VasuPadsumbia/micro-ros-ethercat/docs/micro_ros_ethercat_report.docx

# micro-ROS over EtherCAT

A Complete Implementation: ESP32 ↔ SPI ↔ Tang Nano 20K FPGA ↔ EtherCAT ↔ ROS 2 PC

Vasu
April 2026

# 1. Introduction and Motivation

This document covers the complete design, implementation, and debugging of a system that runs micro-ROS on an ESP32 microcontroller and routes its DDS traffic over EtherCAT to a ROS 2 host PC. The idea came from a need to put a small embedded node on a deterministic industrial bus without adding a full Linux board. EtherCAT gives us sub-100 µs cycle times and a daisy-chain topology that suits robotics. micro-ROS lets me reuse the full ROS 2 ecosystem (topics, services, parameters) on a $5 microcontroller.

The main challenge is that micro-ROS was designed to run over serial, UDP, or USB — not EtherCAT. EtherCAT is a master/slave bus; the slave cannot initiate communication. I had to bridge the two worlds by implementing a custom transport layer and building the EtherCAT slave entirely in FPGA logic, since off-the-shelf EtherCAT slave chips (like Beckhoff ET1100) are expensive and hard to source.

Everything in this project is open-source hardware and software: the Tang Nano 20K FPGA (Gowin GW2A-18), SOEM for the PC-side master, and the micro-ROS ESP-IDF component. The entire toolchain — synthesis, place-and-route, firmware build, agent build — runs from a single shell script.

# 2. System Architecture

The data path has four major hops. Figure 1 shows the block diagram.

┌─────────────────────────────────────────────────────────────────────┐
│ ROS 2 Host PC │
│ ┌──────────────────┐ ┌────────────────────────────────┐ │
│ │ micro-ROS Agent │ │ SOEM EtherCAT Master │ │
│ │ (XRCE-DDS ↔ │◄──────►│ ecx_contextt │ │
│ │ DDS bridge) │ │ VoE mailbox R/W │ │
│ └──────────────────┘ └────────────┬───────────────────┘ │
│ │ Ethernet (NIC) │
└────────────────────────────────────────────┼───────────────────────┘
│ 100BASE-TX
▼
┌─────────────────────────────────────────────────────────────────────┐
│ Tang Nano 20K (GW2A-18C) │
│ │
│ ┌──────────┐ ┌──────────┐ ┌────────────┐ ┌──────────────────┐ │
│ │ mii_mac │ │ ethercat │ │ esc_ │ │ mailbox │ │
│ │ Port 0 │─►│ _slave │─►│ registers │─►│ SM0(out) 256B │ │
│ │ (MII RX/ │ │ datagram │ │ 4 KiB │ │ SM1(in) 256B │ │
│ │ TX + FCS│ │ parser │ │ BRAM │ │ │ │
│ └──────────┘ └──────────┘ └────────────┘ └────────┬─────────┘ │
│ │ spi_slave │
│ ┌──────────────────────────────────────────────────┐ │ │
│ │ mdio_ctrl → AT24C256 EEPROM (i2c_master) │ │ SPI 8MHz │
│ └──────────────────────────────────────────────────┘ │ │
└─────────────────────────────────────────────────────────────────────┘
│
┌────────────────────────────────────────────┘
│ SPI (Mode 0, 8 MHz, CPOL=0, CPHA=0)
│ SCK=GPIO14, MOSI=GPIO13, MISO=GPIO12, CS=GPIO15
│ INT_N=GPIO4 (active-low interrupt from FPGA)
▼
┌───────────────────────────────────────┐
│ ESP32 DevKit V4 │
│ ┌────────────────────────────────┐ │
│ │ micro-ROS (FreeRTOS task) │ │
│ │ rcl / rclc / rmw_microxrcedds│ │
│ │ custom SPI transport │ │
│ │ rmw_uros_set_custom_transport │ │
│ └────────────────────────────────┘ │
└───────────────────────────────────────┘

Figure 1 — Complete system block diagram.

## 2.1 Signal Flow Summary

When the ESP32 publishes a ROS 2 message, the micro-XRCE-DDS serialises it into a UDP-like datagram and hands it to the custom SPI transport. The transport frames it with a 3-byte header (CMD, LEN_H, LEN_L) and a CRC-8 trailer and clocks it into the FPGA over SPI. The FPGA's spi_slave module writes each byte into the SM0 (Mailbox Out) buffer. When the buffer is full, it asserts INT_N low to signal the PC. The PC-side SOEM thread reads the mailbox over EtherCAT using a VoE (Vendor-specific over EtherCAT) read command and passes the raw bytes to the micro-ROS agent. The agent deserialises the XRCE-DDS stream and publishes it into the ROS 2 DDS middleware. The return path is symmetric.

# 3. EtherCAT Protocol Deep Dive

## 3.1 What EtherCAT Is

EtherCAT (Ethernet for Control Automation Technology) is an industrial Ethernet fieldbus standardised as IEC 61158 Type 12. Unlike standard Ethernet where each node receives a packet and sends a reply, EtherCAT uses a "processing-on-the-fly" model. The master sends a frame; each slave reads its portion of the frame and writes back its data into the same frame as it passes through. The last slave in the ring sends the completed frame back to the master. A single 1500-byte Ethernet frame can carry data for all slaves in one cycle.

Key properties that made EtherCAT attractive for this project:

- Deterministic cycle time: typical 31.25 µs to 1 ms, jitter < 1 µs with distributed clocks.
- Standard 100BASE-TX physical layer — uses off-the-shelf DP83848 PHY chips.
- Master runs on a standard PC NIC with no special hardware — only SOEM (open-source library).
- Mailbox protocol for non-cyclic (event-driven) communication — perfect for micro-ROS DDS.
- Daisy-chain topology, no switch needed.

## 3.2 EtherCAT Frame Structure

An EtherCAT frame is a standard Ethernet frame with Ethertype 0x88A4. The payload is one or more EtherCAT datagrams back-to-back:

Ethernet frame:
┌──────────┬──────────┬────────┬──────────────────────────────┬─────┐
│ Dst MAC │ Src MAC │ 0x88A4│ EtherCAT payload (datagrams)│ FCS │
│ 6 bytes │ 6 bytes │ 2 bytes│ up to 1498 bytes │4 B │
└──────────┴──────────┴────────┴──────────────────────────────┴─────┘

EtherCAT datagram (one of N in the payload):
┌────┬────┬──────────┬───────┬────┬────────────────┬─────┬─────┐
│CMD │IDX │ Address │LENGTH │IRQ │ Data │ WKC │ M │
│1 B │1 B │ 4 bytes │ 2 B │2 B │ 0..1486 bytes │2 B │ bit │
└────┴────┴──────────┴───────┴────┴────────────────┴─────┴─────┘
CMD : command — APRD, APWR, FPRD, FPWR, LRD, LWR, BRD, BWR, ARMW...
IDX : index (echo-back ID, incremented by master each cycle)
Address: 32-bit address (auto-increment or fixed-station + offset)
LENGTH : bits[10:0]=data length, bit[14]=circulating, bit[15]=M(ore)
WKC : Working Counter, each matching slave increments by 1, 2, or 3
M bit : set if another datagram follows in this frame

## 3.3 Datagram Commands

Command | Mnemonic | Address Type | Use in This Project
APRD | Auto-Increment Physical Read | Position-based | Master reads data FROM slave
APWR | Auto-Increment Physical Write | Position-based | Master writes data TO slave
FPRD | Fixed-address Physical Read | Station address | After address assignment
FPWR | Fixed-address Physical Write | Station address | Register writes (mailbox)
BRD | Broadcast Read | All slaves | AL status poll
LRW | Logical Read/Write | Logical address | Process data (PDO mapping)
FRMW | Fixed Addr Read Multiple Write | Station address | Distributed clock reference

## 3.4 ESC Register Map (IEC 61158-4-12)

Every EtherCAT slave has a register space (the ESC — EtherCAT Slave Controller). Our FPGA implements this register file in esc_registers.v. The key registers are:

Address | Register | Width | Description
0x0000 | Type | 8 bit | ESC type (0x11 = IP Core with 2 ports)
0x0001 | Revision | 8 bit | 0x01
0x0004–0x0007 | Build | 32 bit | ESC build number
0x0008 | FMMU supported | 8 bit | 8 FMMUs
0x0009 | SM supported | 8 bit | 8 SyncManagers
0x000A | RAM size | 8 bit | 0x10 = 4 KiB
0x0010–0x0011 | Station address | 16 bit | Assigned by master (APWR broadcast)
0x0100 | DL Control | 8 bit | Port enable, loop control
0x0110 | DL Status | 8 bit | Link status
0x0120 | AL Control | 8 bit | Master writes desired state here
0x0130 | AL Status | 8 bit | Slave reports current state
0x0134 | AL Status Code | 16 bit | Error reason
0x0500–0x0507 | EEPROM ctrl/addr/data | — | SII EEPROM access
0x0800–0x083F | SM0–SM7 config | 8×8 bytes | SyncManager 0–7 configuration
0x1000–0x11FF | Dual-port RAM | 512 B | SM0/SM1 mailbox data

## 3.5 AL State Machine

Every EtherCAT slave must implement the Application Layer state machine. The master drives it by writing to AL Control (0x0120); the slave responds by updating AL Status (0x0130). Our implementation in ethercat_slave.v handles the transitions:

INIT (0x01) ──────────────────────────────────────────────────────────────────────►
│ Master configures SyncManagers and FMMUs │
▼ │
PRE-OP (0x02) ──────────────────────────────────────────────────────────────────► │
│ Mailbox communication enabled (SM0/SM1 active) │
▼ │
SAFE-OP (0x04) │
│ Process data inputs run, outputs frozen at 0 │
▼ │
OP (0x08) ◄──── normal operation, all I/O active ──────────────────────────

## 3.6 SyncManager Configuration

SyncManagers are the hardware mechanism that controls mailbox and process data access. Each SM has 8 bytes of configuration at offset 0x0800 + n×8:

Byte offset | Field | Our SM0 (Mailbox Out) | Our SM1 (Mailbox In)
0–1 | Start address | 0x1000 | 0x1100
2–3 | Length | 0x0100 (256 B) | 0x0100 (256 B)
4 | Control | 0x26 (write, Mailbox) | 0x22 (read, Mailbox)
5 | Status | HW managed | HW managed
6 | Activate | 0x01 (enabled) | 0x01 (enabled)
7 | PDI Control | HW managed | HW managed

SM0 is the "Mailbox Out" channel: the master writes data here (FPRD/FPWR to 0x1000–0x10FF). SM1 is "Mailbox In": the master reads from here (FPRD to 0x1100–0x11FF). The working counter mechanism ensures the master knows whether the slave has consumed/produced data.

## 3.7 VoE — Vendor-specific over EtherCAT

The mailbox protocol at the EtherCAT level supports several sub-protocols: CoE (CANopen), SoE (SERCOS), EoE (Ethernet), and VoE (Vendor-specific). I chose VoE because it has no predefined schema — I can put raw bytes in the mailbox and define my own framing on top. A VoE mailbox header is 6 bytes:

EtherCAT mailbox header (6 bytes):
┌──────────────────┬──────────┬────────┬──────┬────────────────────┐
│ Length (2B LE) │ Addr(2B) │Cnt/Prio│ Type │ VoE body │
│ = body length │ 0x0000 │ 0x00 │ 0x0F │ raw XRCE-DDS data │
└──────────────────┴──────────┴────────┴──────┴────────────────────┘
Type 0x0F = VoE

In practice, the SOEM bridge on the PC side reads the raw mailbox buffer and strips the 6-byte EtherCAT header before passing the payload to the micro-ROS agent. This gives us a transparent byte pipe between the ESP32 and the PC, which is exactly what micro-XRCE-DDS needs.

## 3.8 EtherCAT Performance Characteristics

Parameter | Value | Notes
Physical layer | 100BASE-TX | Full-duplex, 100 Mbit/s raw
Effective throughput per slave | ~90 Mbit/s | After preamble/IFG/FCS overhead
Cycle time (typical) | 31.25 µs – 1 ms | Configurable by master
Cycle time jitter | < 1 µs | With distributed clocks enabled
Max datagrams per frame | ~15 | At 1500 B MTU, 10 B header each
Max mailbox size | 1486 B | Limited by Ethernet MTU
Our mailbox size | 256 B | Matches micro-ROS MTU
Max slaves per segment | 65535 | Theoretical; practical < 100
Propagation delay per slave | ~100 ns | FPGA ESC processing latency
SOEM min cycle achievable | ~125 µs | On a Linux RT kernel

# 4. Hardware Components

## 4.1 Tang Nano 20K — GW2A-18C FPGA

The Tang Nano 20K is a low-cost ($18) FPGA development board from Sipeed. The core chip is the Gowin GW2A-18C:

Resource | Count | Used (estimated) | Utilisation
LUT4 (logic cells) | 20,736 | ~2,400 | ~11.6 %
Flip-flops (DFF) | 15,552 | ~1,500 ctrl + 4K mem regs | ~35 %
Block RAM 18Kbit | 55 | 4 (pd_ram, sm0, sm1, eeprom) | 7.3 %
DSP blocks | 48 | 0 | 0 %
Global clocks | 8 | 4 (sys, tx_clk, rx_clk0, rx_clk1) | 50 %
User IO | 83 | ~50 | ~60 %
PLL | 2 | 0 (using onboard 27 MHz directly) | 0 %

The GW2A-18C has 55 BRAM blocks at 18 Kbit each — that is about 123 KB of block RAM total. This is more than sufficient for our EtherCAT buffers. The device is supported by the open-source toolchain apio (yosys + nextpnr-himbaechel + gowin-pack) which we install inside a Python virtual environment — no proprietary IDE required.

## 4.2 ESP32 DevKit V4

The ESP32 is a dual-core 240 MHz Xtensa LX6 microcontroller with 520 KB SRAM and 4 MB flash. We use one core (core 1) for the micro-ROS FreeRTOS task and the other for the system idle task. The SPI peripheral (SPI2 / HSPI) is configured in master mode at 8 MHz. The relevant pins:

GPIO | SPI Signal | Connected to FPGA pin | Direction
GPIO14 | SCLK | spi_sck | ESP32 → FPGA
GPIO13 | MOSI | spi_mosi | ESP32 → FPGA
GPIO12 | MISO | spi_miso | FPGA → ESP32
GPIO15 | CS (active-low) | spi_cs_n | ESP32 → FPGA
GPIO4 | INT_N (active-low interrupt) | spi_int_n | FPGA → ESP32

## 4.3 DP83848 Ethernet PHY

Two DP83848 PHY chips are used (one per EtherCAT port). The PHY handles the analogue 100BASE-TX signalling and presents a 4-bit MII interface to the FPGA running at 25 MHz. The FPGA's mii_mac module connects to this interface. Both PHYs are managed via MDIO (Management Data Input/Output) — a serial protocol at ~2.5 MHz that we implement in mdio_ctrl.v. At startup, mdio_ctrl writes the PHY registers to force 100 Mbit/s full-duplex and enable auto-negotiation.

MII interface pinout per PHY:

TX side (FPGA → PHY, synchronous to TX_CLK from PHY):
TXD[3:0] — 4-bit transmit nibbles
TX_EN — transmit enable
TX_ER — transmit error (we tie low)
TX_CLK — 25 MHz clock INPUT from PHY (FPGA uses this)

RX side (PHY → FPGA, synchronous to RX_CLK from PHY):
RXD[3:0] — 4-bit receive nibbles
RX_DV — receive data valid
RX_ER — receive error
RX_CLK — 25 MHz clock INPUT from PHY

## 4.4 AT24C256 EEPROM

EtherCAT requires each slave to have a small EEPROM (called the SII — Slave Information Interface) that stores vendor ID, product code, mailbox configuration, and CoE object dictionary metadata. The master reads this over MDIO-like SII protocol at startup. We implement the SII in a 256-word (512-byte) cache in BRAM, populated from the AT24C256 (32 KB I2C EEPROM) at boot. The i2c_master.v module reads the EEPROM; the ESC register block services the master's EEPROM read requests.

# 5. FPGA RTL Architecture

## 5.1 Module Hierarchy

top.v
├── mdio_ctrl.v — PHY MDIO initialisation
├── mii_mac.v (×2) — MII MAC with TX preamble/FCS and RX FCS check
├── ethercat_slave.v — EtherCAT datagram processing state machine
├── esc_registers.v — ESC register file + process data RAM
├── mailbox.v — SM0/SM1 buffers + INT_N generation
├── spi_slave.v — SPI slave interface to ESP32
├── i2c_master.v — I2C master for AT24C256 EEPROM
└── crc32.v / (inline) — CRC-32 for Ethernet FCS (nibble-serial)

## 5.2 Clock Domains

Domain | Source | Frequency | Used by
sys_clk (clk_27) | Tang Nano 20K onboard crystal | 27 MHz | All control logic, SPI slave, I2C, register file
tx_clk0 | PHY0 TX_CLK output | 25 MHz | mii_mac port 0 TX state machine
rx_clk0 | PHY0 RX_CLK output | 25 MHz | mii_mac port 0 RX state machine
tx_clk1 | PHY1 TX_CLK output | 25 MHz | mii_mac port 1 TX (currently tied off)
rx_clk1 | PHY1 RX_CLK output | 25 MHz | mii_mac port 1 RX (currently tied off)

All clock domain crossings between the 25 MHz MII domains and the 27 MHz system clock are handled by 2FF synchronisers and Gray-coded pointer asynchronous FIFOs inside mii_mac.v. No PLL is used — the PHY generates a clean 25 MHz from its internal crystal oscillator.

## 5.3 mii_mac.v — MII MAC Layer

The MII MAC is the lowest layer. It translates between the 4-bit MII nibble stream (running at 25 MHz, one nibble per clock) and the byte-stream interface used by the EtherCAT slave core (running at 27 MHz). It handles:

- TX: preamble (7 × 0x55) + SFD (0xD5) generation, CRC-32 FCS append, inter-frame gap (96-bit = 24 nibble clocks).
- RX: preamble stripping, SFD detection, byte assembly, CRC-32 FCS check (residue = 0xC704DD7B).
- Clock domain crossing: 64-entry async FIFO per direction with Gray-coded pointers.

The CRC-32 is computed nibble-by-nibble using the reflected polynomial 0xEDB88320:

function [31:0] crc32_nibble;
input [31:0] crc;
input [3:0] nib;
for (k = 0; k < 4; k = k + 1) begin
if (crc[0] ^ nib[k])
crc = {1'b0, crc[31:1]} ^ 32'hEDB88320;
else
crc = {1'b0, crc[31:1]};
end
endfunction

The async FIFO uses a 7-bit Gray-coded write pointer and a 7-bit Gray-coded read pointer (2-stage synchronised into the opposite domain). Binary recovery uses a chain of XOR gates implemented as an upward-counting generate loop (downward loops caused yosys to hang — a bug we hit and fixed). The FIFO depth is 2^6 = 64 entries — enough for several Ethernet frame bytes to buffer while the 27 MHz domain catches up.

## 5.4 ethercat_slave.v — Datagram Processing

This module receives frames from the mii_mac and processes them byte by byte. It maintains a 512-byte frame buffer (fbuf) in registers. Originally this was 2 KB (2048 bytes), which would have created 16,384 flip-flops — enough to stall yosys for over an hour. Reducing to 512 bytes is correct because our largest EtherCAT mailbox frame is 14 (Eth) + 2 (EtherCAT) + 10 (datagram) + 256 (payload) = 282 bytes.

The receive state machine has three states:

RX_COLLECT — collect bytes into fbuf until rx_last
RX_PROCESS — parse datagrams: check Ethertype 0x88A4, iterate datagrams,
check address match, read/write ESC registers, increment WKC
RX_TRANSMIT — replay modified fbuf through the TX MAC

For each datagram, the module checks whether the datagram's address matches this slave (either auto-increment position check or fixed station address comparison). If it matches, it reads/writes the ESC register space via ec_addr/ec_wdata/ec_rdata. Working counter (WKC) is incremented according to the command type: +1 for read, +1 for write, +3 for read-write (ARMW).

Supported datagram commands (implemented):

- APRD (0x01) — Auto-increment physical read: reads ESC registers by position.
- APWR (0x02) — Auto-increment physical write: writes ESC registers by position.
- FPRD (0x04) — Fixed-station physical read: uses station address register.
- FPWR (0x05) — Fixed-station physical write.
- BRD (0x07) — Broadcast read.
- BWR (0x08) — Broadcast write.

## 5.5 esc_registers.v — Register File

This module implements the full ESC register map as a 16-bit addressed combinatorial decode (casez on ec_addr). Writable registers are backed by register arrays; read-only fields return constants. The key storage elements:

Symbol | Type | Size | Purpose
station_addr_r | reg [7:0][0:1] | 2 bytes | Assigned station address (0x0010)
dl_ctrl_r | reg [7:0][0:1] | 2 bytes | DL control register (0x0100)
al_ctrl_r | reg [7:0][0:1] | 2 bytes | AL control — desired state (0x0120)
sm_r | reg [63:0][0:7] | 64 bytes | 8 SyncManagers × 8 bytes config (0x0800)
eeprom_cache | BRAM 256 B | 256 bytes | SII EEPROM shadow (first 128 words)
pd_ram | reg [7:0][0:511] | 512 bytes | Process data RAM (0x1000–0x11FF)

A key design lesson: the pd_ram originally used a 12-bit index (4096 entries = 32,768 flip-flops) which crashed yosys. Reducing to 9-bit (512 entries matching SM0+SM1 = 0x1000–0x11FF) brought the register count down to manageable levels. The sm_r register is packed as a flat 512-bit vector for Verilog-2001 compatibility (yosys does not support SystemVerilog 2D packed arrays in port declarations).

## 5.6 mailbox.v — SM0/SM1 Buffers

The mailbox module manages two 256-byte buffers: SM0 (Mailbox Out — master writes, SPI reads) and SM1 (Mailbox In — SPI writes, master reads). It also generates the INT_N interrupt signal to the ESP32 (active-low, asserted when SM0 has data for the ESP32 to read).

SM0 write (EtherCAT master → SM0 → ESP32 via SPI):
1. Master sends FPWR datagram to address 0x1000–0x10FF
2. ethercat_slave asserts ec_wr for each byte
3. mailbox stores byte at sm0_buf[ec_addr - MBX_OUT_BASE]
4. On sm0_written pulse, mailbox sets mbox_out_ready=1, asserts INT_N
5. spi_slave detects INT_N and sends data to ESP32 on next CMD=0x02 read

SM1 write (ESP32 via SPI → SM1 → EtherCAT master):
1. ESP32 sends CMD=0x01 write to spi_slave
2. spi_slave asserts mbox_wr_valid for each payload byte
3. mailbox stores byte at sm1_buf[sm1_wr_ptr++]
4. When full, sets mbox_in_ready=1
5. Master polls SM1 (FPRD 0x1100), sees data, reads it

## 5.7 spi_slave.v — SPI Interface

The SPI slave runs Mode 0 (CPOL=0, CPHA=0), MSB first, at up to 8 MHz. The SPI clock from the ESP32 is asynchronous to the 27 MHz sys_clk, so the module uses a 3-stage synchroniser on SCK, CS, and MOSI before edge detection:

sck_rise = (sck_sync[2:1] == 2'b01) // rising edge
sck_fall = (sck_sync[2:1] == 2'b10) // falling edge
cs_active = !cs_sync[1]

The SPI protocol uses a 3-byte header + payload + CRC-8:

Frame format (both TX and RX):
Byte 0 : Command
0x01 = Write to FPGA mailbox (ESP32 → FPGA)
0x02 = Read from FPGA mailbox (FPGA → ESP32)
0x03 = Status query
Byte 1–2 : Payload length (big-endian, 16-bit)
Byte 3…N : Payload
Byte N+1 : CRC-8 (poly 0x07, init 0x00) over bytes 0…N

Status response (CMD=0x03), 3 bytes:
Byte 0 : Flags — bit0=rx_data_available, bit1=tx_ready
Byte 1–2: Number of bytes available in SM0

The state machine (F_CMD → F_LEN_H → F_LEN_L → F_DATA → F_CRC) runs in a single clocked always block. MISO is pre-loaded with the next byte on each falling edge of SCK so data is stable before the next rising edge capture.

# 6. Complete Wiring Diagram

┌──────────────────────────────────────────────────────────────────────────────┐
│ WIRING DIAGRAM — micro-ROS over EtherCAT │
└──────────────────────────────────────────────────────────────────────────────┘

PC (Ubuntu / ROS 2)
NIC eth0 ──────── RJ45 patch cable ──────────────────────────────────────┐
│
100BASE-TX (Cat5e/6) │
│
Tang Nano 20K FPGA Board │
┌──────────────────────────────────────────────────────────────────────┐ │
│ │ │
│ DP83848 PHY0 │ │
│ RJ45 ──── MDI pairs ───► PHY0 ────────────────────────────────────┼──┘
│ │ │
│ TX_CLK (25 MHz) ─────────┼───► FPGA pin p0_tx_clk │
│ RX_CLK (25 MHz) ─────────┼───► FPGA pin p0_rx_clk │
│ TXD[3:0] ◄────────┼──── FPGA pin p0_txd[3:0] │
│ TX_EN ◄────────┼──── FPGA pin p0_tx_en │
│ RXD[3:0] ─────────┼───► FPGA pin p0_rxd[3:0] │
│ RX_DV ─────────┼───► FPGA pin p0_rx_dv │
│ MDC ◄────────┼──── FPGA pin p0_mdc │
│ MDIO ◄───────►┼──── FPGA pin p0_mdio (open-drain) │
│ RST_N ◄────────┼──── FPGA pin p0_rst_n │
│ │ │
│ AT24C256 EEPROM │ │
│ SCL ◄───────────────────────── FPGA i2c_scl (open-drain) │
│ SDA ◄──────────────────────── FPGA i2c_sda (open-drain) │
│ VCC = 3.3V, GND, A0=A1=A2=0 (addr 0x50) │
│ │
│ SPI slave port │
│ spi_sck ─────────────────────────────────────────────────────┐ │
│ spi_mosi ──────────────────────────────────────────────────┐ │ │
│ spi_miso ───────────────────────────────────────────────┐ │ │ │
│ spi_cs_n ────────────────────────────────────────────┐ │ │ │ │
│ spi_int_n────────────────────────────────────────────┼──┼──┼──┼───┼─┐
│ │ │ │ │ │ │
└─────────────────────────────────────────────────────────┼──┼──┼──┼───┘ │
│ │ │ │ │
ESP32 DevKit V4 │ │ │ │ │
┌─────────────────────────────────────────────────────────┴──┴──┴──┴──┐ │
│ GPIO15 (CS) ────────────────────────────────────────────────────┘ │
│ GPIO14 (SCLK) │
│ GPIO13 (MOSI) │
│ GPIO12 (MISO) │
│ GPIO4 (INT_N) ◄──────────────────────────────────────────────────────┘
│ │
│ SPI2 (HSPI) peripheral — Mode 0, 8 MHz, MSB first │
│ FreeRTOS + micro-ROS task │
└─────────────────────────────────────────────────────────────────────────┘

Power:
Tang Nano 20K : USB-C 5V (onboard regulator → 3.3V for FPGA and PHYs)
ESP32 DevKit : USB Micro-B 5V (onboard regulator → 3.3V)
Logic levels : 3.3V on all signal lines (compatible)

# 7. ESP32 Firmware — micro-ROS over SPI

## 7.1 micro-ROS Architecture

micro-ROS runs on top of FreeRTOS using the ESP-IDF component micro_ros_espidf_component. The stack is:

ROS 2 application layer: rcl (ROS Client Library)
rclc (C convenience layer: executor, timers)
Middleware: rmw_microxrcedds (RMW implementation)
Transport: XRCE-DDS (micro-XRCE-DDS-Client)
Custom transport: spi_transport.c (our implementation)
Hardware: ESP32 SPI2 (HSPI)

The custom transport is registered at startup with rmw_uros_set_custom_transport(), providing four callbacks: open, close, write, read. This function is only available when the micro-ROS library is compiled with RMW_UXRCE_TRANSPORT=custom in app-colcon.meta — a lesson we learned after a linker error showed the symbol missing from libmicroros.a (which had been built with RMW_UXRCE_TRANSPORT=udp).

## 7.2 SPI Transport Implementation

The write callback:

1. Poll FPGA status via CMD=0x03 until TX_READY bit is set (up to 100 ms).
2. Build SPI frame: [0x01][LEN_H][LEN_L][payload][CRC8].
3. Execute full-duplex SPI transaction via spi_device_polling_transmit().

The read callback:

4. Poll until RX_DATA_AVAILABLE bit is set or timeout expires.
5. Send CMD=0x02 with length from status response.
6. Extract payload from SPI RX buffer, verify CRC-8.

CRC-8 uses polynomial 0x07, init 0x00 — computed over all bytes from CMD through the last payload byte. This detects single-bit errors on the SPI lines.

## 7.3 Build System — ESP-IDF

The firmware build uses ESP-IDF v5.3, installed to tools/esp-idf/ (not the default ~/.espressif). The IDF_TOOLS_PATH environment variable redirects the toolchain downloads to tools/espressif/. A critical issue was that running idf.py inside an active Python venv caused "cannot import yaml" — the IDF uses its own Python env (idf5.3_py3.14_env) and the project venv was shadowing it. The fix in run.sh strips .venv/bin from PATH before sourcing export.sh.

# 8. PC Agent — SOEM + micro-ROS

## 8.1 SOEM — Simple Open EtherCAT Master

SOEM is an open-source EtherCAT master library written in C. It runs on a raw socket (Linux) and sends/receives EtherCAT frames directly, bypassing the kernel's network stack. The modern SOEM API uses a context object (ecx_contextt) that embeds all state — no external arrays need to be wired up:

ecx_contextt ctx_; // single context object, fully self-contained
uint8_t iobuf_[4096]; // I/O map buffer

memset(&ctx_, 0, sizeof(ctx_));
ecx_config_init(&ctx_); // 1 argument (not 2 — old API had FALSE)
ecx_config_map_group(&ctx_, iobuf_, 0); // not ecx_config_map
ecx_configdc(&ctx_);

A common pitfall: the ecx_portt type (needed by ecx_contextt) is defined in the Linux oshw header (nicdrv.h), which must be included BEFORE ec_main.h. The build would fail with "ecx_portt undeclared" without this ordering.

## 8.2 VoE Mailbox Bridge

The soem_bridge.cpp module runs two threads: a TX thread that reads from the micro-ROS agent output queue and writes to the slave mailbox via FPWR datagrams, and an RX thread that polls the slave mailbox via FPRD datagrams and feeds incoming bytes to the agent input queue. The poll interval is 1 ms (yielding effective micro-ROS latency of 1–2 ms end-to-end).

The mailbox write sequence in SOEM:

// Write to SM0 (Mailbox Out at 0x1000, slave 1)
ecx_mbxsend(&ctx_, 1 /*slave*/, &mbx_out, EC_TIMEOUTTXM);

// Read from SM1 (Mailbox In at 0x1100)
ecx_mbxreceive(&ctx_, 1, &mbx_in, EC_TIMEOUTTXM);

# 9. Build System and Toolchain

## 9.1 Directory Structure

micro-ros-ethercat/
├── run.sh — main orchestrator script
├── config.in — build configuration variables
├── setup.sh — one-time environment setup
├── .venv/ — Python virtual environment (apio, etc.)
├── tools/
│ ├── esp-idf/ — ESP-IDF v5.3 source
│ ├── espressif/ — ESP-IDF toolchain (xtensa-esp-elf, etc.)
│ └── apio/ — apio packages (oss-cad-suite, gowin)
├── ethercat-slave/
│ ├── rtl/ — Verilog RTL source files
│ ├── sim/ — Testbenches (guarded with `ifndef SYNTHESIZE)
│ ├── eeprom/ — EEPROM binary generator
│ └── apio.ini — apio project: board=sipeed-tang-nano-20k
├── firmware/
│ ├── main/ — main.c, spi_transport.c/h
│ ├── components/ — micro_ros_espidf_component
│ ├── app-colcon.meta — override: RMW_UXRCE_TRANSPORT=custom
│ └── sdkconfig.defaults — IDF target, flash size, SPI config
├── agent/
│ ├── src/ — ethercat_transport.cpp, soem_bridge.cpp
│ ├── include/ — ethercat_transport.h
│ ├── test/ — GTest unit tests with mock SOEM
│ └── soem/ — SOEM git submodule
└── logs/ — per-command build logs

## 9.2 run.sh Command Reference

Command | What it does | Log file
./run.sh --build agent | CMake + make of PC agent (libSOEM + GTest) | logs/build_agent.log
./run.sh --build firmware | idf.py build of ESP32 firmware | logs/build_firmware.log
./run.sh --build slave | apio build: yosys + nextpnr + gowin-pack | logs/build_slave.log
./run.sh --build all | All three above in sequence | logs/build_all.log
./run.sh --test agent | cmake -DBUILD_TESTS=ON + ctest | logs/test_agent.log
./run.sh --load-ecat | apio upload: flash FPGA bitstream via USB | logs/load-ecat.log
./run.sh --load-mcu | idf.py flash over UART | logs/load-mcu.log
./run.sh --run agent | sudo ./agent --iface eth0 --slave 1 | logs/run.log
./run.sh --clean all | Remove all generated files (tools/, .venv/, builds) | —

## 9.3 apio — FPGA Toolchain

apio is a pip-installable wrapper around oss-cad-suite that manages yosys (synthesis), nextpnr (place-and-route), and gowin-pack (bitstream generation). Key configuration in ethercat-slave/apio.ini:

[env:default]
board = sipeed-tang-nano-20k
top-module = top

apio passes -DSYNTHESIZE to yosys, so testbench files are wrapped with `ifndef SYNTHESIZE / `endif to prevent simulation code from being synthesised. The APIO_HOME environment variable (not APIO_HOME_DIR) controls where apio installs its packages — we set it to tools/apio/ to keep everything in-workspace.

# 10. Issues Faced and How We Solved Them

This section documents every significant problem encountered during development, in roughly chronological order. I am including it because these are the kinds of things that take hours to debug and are rarely written down.

## 10.1 SOEM: ecx_portt undeclared

Problem:

Including ec_main.h before nicdrv.h caused ecx_portt to be undefined.

Solution:

nicdrv.h (from oshw/linux/) must be included BEFORE ec_main.h. The ecx_portt struct is defined in the OS-specific hardware layer, not the core SOEM headers.

## 10.2 SOEM: ecx_config_init takes 1 argument, not 2

Problem:

Old SOEM docs/examples showed ecx_config_init(&ctx, FALSE). Modern SOEM embeds all arrays inside ecx_contextt — no external arrays, no second argument.

Solution:

Changed to ecx_config_init(&ctx_). Also ecx_config_map() no longer exists; use ecx_config_map_group(&ctx_, iobuf_, 0).

## 10.3 Mock SOEM for GTest: C-linkage overload error

Problem:

Declaring mock functions in a C++ header with extern "C" and then having C++ overloads caused a compilation error.

Solution:

Split declarations into a separate mock_soem.cpp with the extern "C" block. The header includes the SOEM headers in the correct order.

## 10.4 ESP-IDF venv conflict

Problem:

Running ./run.sh inside an active Python venv caused install.sh to fail because it tried to use the venv's pip instead of the system pip.

Solution:

The install.sh subshell unsets VIRTUAL_ENV and VIRTUAL_ENV_PROMPT, and strips .venv/bin from PATH before running.

## 10.5 idf.py: "Cannot import yaml"

Problem:

idf.py was found in PATH but the .venv Python (which lacks yaml) was used instead of the ESP-IDF Python env.

Solution:

require_idf() in run.sh strips .venv/bin from PATH before sourcing export.sh, allowing the ESP-IDF Python env to take precedence.

## 10.6 micro-ROS: rmw_uros_set_custom_transport undefined at link

Problem:

The function compiled fine but was missing from libmicroros.a at link time.

Solution:

libmicroros.a was built with RMW_UXRCE_TRANSPORT=udp. Created app-colcon.meta with RMW_UXRCE_TRANSPORT=custom. Deleted micro_ros_src/ and libmicroros.a to force a full rebuild of the micro-ROS library.

## 10.7 Verilog: SystemVerilog array ports rejected by yosys

Problem:

output wire [63:0] sm_cfg [0:7] is SystemVerilog unpacked array syntax, not Verilog-2001. yosys errored with "syntax error, unexpected [" at port list.

Solution:

Flattened to output wire [511:0] sm_cfg (8 × 64 = 512 bits packed vector). Similarly, reg [7:0] sm_r [0:7][0:7] was flattened to reg [63:0] sm_r [0:7].

## 10.8 Verilog: output reg with assign statement

Problem:

al_control, station_addr, dl_ctrl were declared as output reg but driven by assign statements. Yosys warned "reg assigned in continuous assignment".

Solution:

Changed port declarations to output wire since assign is a continuous driver.

## 10.9 RTL: multiple conflicting drivers for spi.bit_pos

Problem:

The bit_pos register was driven in two separate always blocks: the shift register block and the frame FSM block (line: bit_pos <= 7 in cs_deassert handler).

Solution:

Removed the redundant bit_pos <= 7 from the FSM block — the shift register block already handles this on cs_active going low.

## 10.10 RTL: multiple conflicting drivers for pd_ram

Problem:

pd_ram was written in two separate always blocks: one for the EC interface and one for the PDI interface.

Solution:

Merged into a single always @(posedge clk) block with EC writes having priority over PDI writes (else-if chain).

## 10.11 RTL: pdi_wdata/pdi_addr/pdi_wr/pdi_rd not driven

Problem:

These wires were declared in top.v and connected to esc_registers but never driven from anywhere, causing "has no driver" warnings.

Solution:

Since the SPI slave feeds the mailbox (not esc_registers directly), these PDI ports are unused. Tied to constants directly in the instantiation: .pdi_addr(16'h0), .pdi_wr(1'b0), etc.

## 10.12 mii_mac.v: downward generate loop hangs yosys

Problem:

for (gi = FIFO_DEPTH-1; gi >= 0; gi = gi - 1) in a generate block caused yosys to run indefinitely (or for > 12 minutes) before being killed.

Solution:

Rewrote all four downward loops as upward loops: for (gi = 0; gi < FIFO_DEPTH; gi = gi + 1) with index arithmetic assign bin[FIFO_DEPTH-1-gi] = bin[FIFO_DEPTH-gi] ^ gray[FIFO_DEPTH-1-gi].

## 10.13 yosys: fbuf (2 KB) expands to 16,384 flip-flops, synthesis hangs

Problem:

The frame buffer was declared as reg [7:0] fbuf [0:2047]. With multiple simultaneous reads at different offsets (fbuf[dg_ptr], fbuf[dg_ptr+1], ...) yosys cannot infer BRAM and expands it to ~16K flip-flops, stalling for hours.

Solution:

Reduced FRAME_BUF_SZ from 11 (2048 B) to 9 (512 B). Our largest EtherCAT mailbox frame is 282 bytes so 512 bytes is sufficient with margin.

## 10.14 yosys: pd_ram BRAM inference fails with "no valid mapping found"

Problem:

Added (* ram_style = "block" *) to pd_ram (4096 bytes) but yosys errored because pd_ram has an asynchronous read port (in always @(*) block). BRAM requires synchronous reads.

Solution:

Reduced pd_ram from 4096 to 512 bytes (matching the 0x1000–0x11FF SM range) and removed the BRAM attribute. 512 bytes as registers = 4096 FFs, manageable.

## 10.15 apio: .apio directory appearing in home directory

Problem:

Packages were being installed to ~/.apio instead of the workspace.

Solution:

The correct environment variable is APIO_HOME (not APIO_HOME_DIR). Set export APIO_HOME="$TOOLS_DIR/apio" in run.sh.

## 10.16 apio: "Unknown board id tangnano20k"

Problem:

The apio.ini had board = tangnano20k which is not a valid board ID.

Solution:

Correct ID found via apio boards command: sipeed-tang-nano-20k.

## 10.17 apio: "section [env] warning"

Problem:

apio ≥ 0.9 requires [env:default] as the section name, not [env].

Solution:

Updated apio.ini to [env:default].

## 10.18 micro-ROS colcon build: catkin_pkg not found

Problem:

The colcon build (inside libmicroros.mk) runs in the ESP-IDF Python env (idf5.3_py3.14_env), not our project venv. catkin_pkg was missing there.

Solution:

Installed catkin_pkg colcon-common-extensions empy lark into the ESP-IDF Python env using its own pip binary. Added this step to setup.sh.

# 11. FPGA Resource Utilisation

## 11.1 LUT Breakdown by Module

Module | LUT4 (est.) | FF (est.) | BRAM blocks | Notes
crc32 (nibble serial) | 64 | 0 | 0 | Purely combinatorial 4-bit XOR tree
mii_mac (×1 instance) | 350 | 220 | 0 | TX/RX FSMs + async FIFO pointer logic
ethercat_slave | 750 | 350 + 4096 mem | 0 | fbuf 512B as registers; datagram parser
esc_registers | 450 | 250 + 4096 mem | 1 | Register decode + pd_ram 512B + eeprom BRAM
mailbox | 250 | 120 + 4096 mem | 2 | sm0_buf + sm1_buf 256B each in BRAM
spi_slave | 220 | 110 | 0 | Synchronisers + shift reg + FSM
mdio_ctrl | 120 | 80 | 0 | Bit-bang MDIO state machine
i2c_master | 110 | 90 | 0 | I2C byte-level state machine
top / glue | 90 | 30 | 0 | Reset sync, PHY reset counter, LED assigns
TOTAL (estimated) | ~2,400 | ~1,250 + 12,288 | 3–4 | ~11.6% of 20,736 LUT4s

Note: The memory flip-flops (fbuf, pd_ram) dominate the FF count if not mapped to BRAM. With proper BRAM inference for sm0_buf and sm1_buf, the FF count drops significantly. The GW2A-18C has 15,552 flip-flops; without BRAM inference for the memories, the design would exceed this limit.

## 11.2 Memory Usage Summary

Memory | Size | Type | Access pattern | Inference
pd_ram | 512 × 8b | ESC process data | Async read, sync write | Registers (async read prevents BRAM)
sm0_buf | 256 × 8b | Mailbox Out buffer | Sync write, async read | Target: BRAM (hint added)
sm1_buf | 256 × 8b | Mailbox In buffer | Sync write, sync read | Target: BRAM
eeprom_cache | 256 × 8b | SII shadow | Sync write, async read | Target: BRAM (hint added)
fbuf | 512 × 8b | Frame buffer | Multi-address read/write | Registers (multi-port prevents BRAM)
txf_mem (mii_mac) | 64 × 9b | TX async FIFO | Sync W, sync R | Registers (small)
rxf_mem (mii_mac) | 64 × 10b | RX async FIFO | Sync W, sync R | Registers (small)
sm_r | 8 × 64b | SM config regs | Sync W, comb R | Registers (tiny)

# 12. Performance Analysis

## 12.1 End-to-End Latency Budget

Stage | Latency | Notes
ESP32 publish() call to SPI frame start | < 1 µs | XRCE-DDS serialise + SPI peripheral setup
SPI transfer (256 byte payload) | ~256 µs | 256 × 8 bits / 8 MHz
FPGA SPI → mailbox buffer | < 1 µs | Byte-synchronous, registered at sys_clk
FPGA mailbox → EtherCAT frame | < 2 µs | Next frame cycle pick-up
EtherCAT frame propagation | ~100 ns/slave + 1 frame | 1 frame = 1518B / 100Mbps = 121 µs
SOEM poll interval (Linux) | 1 ms | Non-RT kernel; with PREEMPT_RT: ~125 µs
SOEM VoE read processing | < 100 µs | ecx_mbxreceive() call
micro-ROS agent DDS publish | < 1 ms | In-process loopback if collocated
TOTAL (non-RT kernel) | ~3–5 ms | Dominated by SOEM poll interval
TOTAL (PREEMPT_RT kernel) | ~0.5–1 ms | Achievable with proper RT scheduling

## 12.2 Throughput

The micro-ROS XRCE-DDS session uses a 256-byte mailbox. At a 1 ms SOEM poll rate, the maximum throughput is 256 bytes × 1000 Hz = 256 KB/s = 2.048 Mbit/s. This is well within the EtherCAT channel capacity (~90 Mbit/s per slave). The actual limiting factor is the SPI transfer time: 256 bytes at 8 MHz SPI takes 256 µs, which means the ESP32 can push at most one full 256-byte packet every 256 µs — about 3.9 × the SOEM poll rate, so the SPI side is not the bottleneck.

For a typical micro-ROS application (sensor data at 100 Hz, 64 bytes per message), the actual data rate is 6.4 KB/s — less than 3% of the channel capacity. There is substantial headroom for adding more topics, services, or parameters.

# 13. Testing Strategy

## 13.1 PC Agent — GTest with Mock SOEM

The PC agent has 16 GTest unit tests that run without real hardware. SOEM functions (ecx_config_init, ecx_config_map_group, ecx_configdc, ecx_mbxsend, ecx_mbxreceive) are replaced by mock implementations in mock_soem.cpp. The mocks use extern "C" linkage to match the C-language SOEM API and are placed in a separate .cpp file to avoid C-linkage overload errors. The tests verify: mailbox read/write, state machine transitions, VoE framing, and error handling paths.

## 13.2 FPGA Simulation — Testbenches

Each major module has a corresponding testbench in ethercat-slave/sim/:

- tb_mii_mac.v — sends synthetic Ethernet frames and checks FCS.
- tb_ethercat_slave.v — injects EtherCAT datagrams, checks WKC increment and register R/W.
- tb_mailbox.v — verifies SM0/SM1 write/read sequences and INT_N assertion.
- tb_spi_slave.v — exercises CMD_WRITE, CMD_READ, CMD_STATUS.

Testbenches are guarded with `ifndef SYNTHESIZE / `endif so they are excluded from the apio synthesis flow (apio passes -DSYNTHESIZE to yosys).

# 14. Conclusion and Future Work

I built a complete EtherCAT slave in FPGA logic from scratch — something that is usually done with a dedicated ASIC (Beckhoff ET1100, LAN9252, etc.) — and integrated it with micro-ROS running on a $5 ESP32. The system works end-to-end: the ESP32 publishes ROS 2 topics that appear on the PC without any modification to the ROS 2 application layer.

Things that worked well:

- The VoE mailbox approach gives a completely transparent byte pipe — no protocol awareness needed at the ROS layer.
- SOEM on Linux is extremely capable; the ecx_contextt-based API is clean once you find the right headers.
- apio makes open-source FPGA synthesis practical; the whole toolchain installs with pip install apio.
- The custom SPI transport in micro-ROS is a clean extension point — four callbacks and you have a new transport.

Things I would do differently:

- Use synchronous reads for all BRAM-candidate memories from the start — async reads prevent BRAM inference and waste flip-flops.
- Start with a smaller frame buffer (512 bytes) rather than 2 KB — there is no need to buffer a full Ethernet MTU for mailbox-only traffic.
- Use PREEMPT_RT on the PC from day one to get proper EtherCAT cycle timing.

Future work:

- Distributed clocks: implement the DC clock synchronisation registers (0x0900–0x0980) to achieve sub-µs slave clock accuracy.
- Process data objects (PDO): add FMMU mapping to support cyclic process data alongside the mailbox.
- Port 1 (second PHY): enable the second EtherCAT port for daisy-chaining multiple slaves.
- CoE: implement CANopen over EtherCAT for standardised device profiles.
