VasuPadsumbia/micro-ros-ethercat/ethercat-slave/rtl/esc_registers.v

// ============================================================================
// esc_registers.v — EtherCAT Slave Controller register file
//
// Implements the standard ESC register space (ETG.1000.4 Table 1):
//   0x0000–0x000F  Fixed info (ROM): type, revision, RAM size, port descriptor
//   0x0010–0x0011  Configured station address (RW)
//   0x0012–0x0013  Configured station alias (from EEPROM)
//   0x0100–0x0101  DL Control
//   0x0110–0x0111  DL Status
//   0x0120–0x0121  AL Control   (master writes desired state)
//   0x0130–0x0131  AL Status    (slave writes current state)
//   0x0134–0x0135  AL Status Code
//   0x0200         PDI Control
//   0x0204–0x0207  EEPROM access registers
//   0x0500–0x0507  SII EEPROM interface registers
//   0x0800–0x087F  SyncManager 0-7 (8 bytes each, 8 SMs max)
//   0x1000–0x1FFF  Process data RAM (4 KiB, dual-port)
//
// All registers are accessed as bytes.  The EtherCAT datagram processor
// in ethercat_slave.v provides the byte address + read/write strobe.
// ============================================================================
module esc_registers (
    input  wire        clk,
    input  wire        rst_n,

    // EtherCAT datagram port
    input  wire [15:0] ec_addr,
    input  wire [7:0]  ec_wdata,
    output reg  [7:0]  ec_rdata,
    input  wire        ec_wr,
    input  wire        ec_rd,

    // SPI/PDI port (for mailbox access to process data RAM)
    input  wire [15:0] pdi_addr,
    input  wire [7:0]  pdi_wdata,
    output reg  [7:0]  pdi_rdata,
    input  wire        pdi_wr,
    input  wire        pdi_rd,

    // EEPROM interface
    output reg  [15:0] eeprom_word_addr,
    output reg         eeprom_req,
    input  wire [15:0] eeprom_rdata,
    input  wire        eeprom_ack,

    // AL state machine outputs
    output wire [3:0]  al_control,   // desired state from master (bits 3:0)
    output reg  [3:0]  al_status,    // current state (written by app logic)
    input  wire [3:0]  al_state_in,  // application sets current AL state
    input  wire [15:0] al_status_code_in,

    // Station address
    output wire [15:0] station_addr,

    // DL control / status
    output wire [7:0]  dl_ctrl,
    input  wire [7:0]  dl_status_in,

    // SyncManager configurations: 8 SMs × 64 bits, flat packed bus
    // Byte b of SM g = sm_cfg[g*64 + b*8 +: 8]
    // Layout per SM: {pdi_ctrl[7:0], act[7:0], status[7:0], ctrl[7:0], len[15:0], start_addr[15:0]}
    output wire [511:0] sm_cfg  // 8 × 64-bit, Verilog-2001 compatible flat vector
);

    // ── ROM: fixed registers ──────────────────────────────────────────────
    // ESC type 0x01 = single-port IP core
    // SM count = 2 (SM0 mailbox out, SM1 mailbox in)
    // Port 0: MII only (single-slave, no Port 1)
    localparam [7:0] ESC_TYPE     = 8'h01;
    localparam [7:0] ESC_REVISION = 8'h01;
    localparam [7:0] ESC_BUILD_L  = 8'h01;
    localparam [7:0] ESC_BUILD_H  = 8'h00;
    localparam [7:0] ESC_FMMU_N   = 8'h02;
    localparam [7:0] ESC_SM_N     = 8'h02;   // Only SM0 + SM1 implemented
    localparam [7:0] ESC_RAM_SIZE = 8'h10;
    localparam [7:0] ESC_PORT_DESC= 8'h01;   // Port0=MII, Port1=not implemented

    // ── Writable registers (single-cycle write) ───────────────────────────
    reg [7:0]  station_addr_r [0:1];
    reg [7:0]  station_alias_r[0:1];
    reg [7:0]  dl_ctrl_r      [0:1];
    reg [7:0]  al_ctrl_r      [0:1];
    reg [7:0]  eeprom_ctrl_r  [0:3]; // 0x0500–0x0503
    reg [7:0]  eeprom_addr_r  [0:1]; // 0x0504–0x0505

    // SyncManager registers: only SM0 and SM1 (mailbox channels).
    // Stored as individual 64-bit registers to avoid expensive variable
    // double-index synthesis (was: sm_r[3-bit][3-bit*8 +: 8] → huge mux tree).
    reg [63:0] sm0_r;   // SM0: master→slave mailbox
    reg [63:0] sm1_r;   // SM1: slave→master mailbox

    // Process data RAM — 128 bytes (0x1000-0x107F).
    // Synchronous read on EC port → BRAM inference on GW2AR-18.
    reg [7:0]  pd_ram [0:127];
    reg [7:0]  pd_ram_rdata;

    // ── EEPROM shadow (first 16 words = 32 bytes cached) ─────────────────
    reg [7:0]  eeprom_cache [0:31];
    reg [7:0]  eeprom_cache_rdata_lo, eeprom_cache_rdata_hi;
    reg        eeprom_cache_valid;

    // ── Output wiring ─────────────────────────────────────────────────────
    assign al_control   = al_ctrl_r[0][3:0];
    assign station_addr = {station_addr_r[1], station_addr_r[0]};
    assign dl_ctrl      = dl_ctrl_r[0];

    // sm_cfg: only SM0 and SM1 packed into lower 128 bits.
    // Upper bits unused — Yosys will trim them.
    assign sm_cfg[63:0]    = sm0_r;
    assign sm_cfg[127:64]  = sm1_r;
    assign sm_cfg[511:128] = {384{1'b0}};

    // ── EtherCAT register read ────────────────────────────────────────────
    always @(*) begin
        ec_rdata = 8'hFF;
        casez (ec_addr)
        // Fixed info
        16'h0000: ec_rdata = ESC_TYPE;
        16'h0001: ec_rdata = ESC_REVISION;
        16'h0002: ec_rdata = ESC_BUILD_L;
        16'h0003: ec_rdata = ESC_BUILD_H;
        16'h0004: ec_rdata = ESC_FMMU_N;
        16'h0005: ec_rdata = ESC_SM_N;
        16'h0006: ec_rdata = ESC_RAM_SIZE;
        16'h0007: ec_rdata = ESC_PORT_DESC;
        16'h0008: ec_rdata = 8'h00; // ESC features lo
        16'h0009: ec_rdata = 8'h00; // ESC features hi
        // Station address
        16'h0010: ec_rdata = station_addr_r[0];
        16'h0011: ec_rdata = station_addr_r[1];
        16'h0012: ec_rdata = station_alias_r[0];
        16'h0013: ec_rdata = station_alias_r[1];
        // DL Control/Status
        16'h0100: ec_rdata = dl_ctrl_r[0];
        16'h0101: ec_rdata = dl_ctrl_r[1];
        16'h0110: ec_rdata = dl_status_in;
        16'h0111: ec_rdata = 8'h00;
        // AL Control
        16'h0120: ec_rdata = al_ctrl_r[0];
        16'h0121: ec_rdata = al_ctrl_r[1];
        // AL Status
        16'h0130: ec_rdata = {4'h0, al_state_in};
        16'h0131: ec_rdata = 8'h00;
        16'h0134: ec_rdata = al_status_code_in[7:0];
        16'h0135: ec_rdata = al_status_code_in[15:8];
        // EEPROM SII registers
        16'h0500: ec_rdata = eeprom_ctrl_r[0];
        16'h0501: ec_rdata = eeprom_ctrl_r[1];
        16'h0502: ec_rdata = eeprom_ctrl_r[2];
        16'h0503: ec_rdata = eeprom_ctrl_r[3];
        16'h0504: ec_rdata = eeprom_addr_r[0];
        16'h0505: ec_rdata = eeprom_addr_r[1];
        16'h0506: ec_rdata = eeprom_cache_valid ? eeprom_cache_rdata_lo : 8'hFF;
        16'h0507: ec_rdata = eeprom_cache_valid ? eeprom_cache_rdata_hi : 8'hFF;
        // SyncManagers: only SM0 (0x0800-0x0807) and SM1 (0x0808-0x080F)
        // Explicit registers eliminate the 8-entry array variable-index mux.
        16'h0800: ec_rdata = sm0_r[ 7: 0];
        16'h0801: ec_rdata = sm0_r[15: 8];
        16'h0802: ec_rdata = sm0_r[23:16];
        16'h0803: ec_rdata = sm0_r[31:24];
        16'h0804: ec_rdata = sm0_r[39:32];
        16'h0805: ec_rdata = sm0_r[47:40];
        16'h0806: ec_rdata = sm0_r[55:48];
        16'h0807: ec_rdata = sm0_r[63:56];
        16'h0808: ec_rdata = sm1_r[ 7: 0];
        16'h0809: ec_rdata = sm1_r[15: 8];
        16'h080A: ec_rdata = sm1_r[23:16];
        16'h080B: ec_rdata = sm1_r[31:24];
        16'h080C: ec_rdata = sm1_r[39:32];
        16'h080D: ec_rdata = sm1_r[47:40];
        16'h080E: ec_rdata = sm1_r[55:48];
        16'h080F: ec_rdata = sm1_r[63:56];
        // Process data RAM (128 B: 0x1000-0x107F) — synchronous read registered output
        16'h10??: ec_rdata = pd_ram_rdata;
        default: ec_rdata = 8'hFF;
        endcase
    end

    // Synchronous read for pd_ram and eeprom_cache (enables BRAM inference)
    always @(posedge clk) begin
        pd_ram_rdata          <= pd_ram[ec_addr[6:0]];
        eeprom_cache_rdata_lo <= eeprom_cache[{eeprom_addr_r[0][3:0], 1'b0}];
        eeprom_cache_rdata_hi <= eeprom_cache[{eeprom_addr_r[0][3:0], 1'b1}];
    end

    // ── EtherCAT register write ───────────────────────────────────────────
    always @(posedge clk or negedge rst_n) begin
        if (!rst_n) begin
            station_addr_r[0] <= 8'h00; station_addr_r[1] <= 8'h00;
            station_alias_r[0]<= 8'h00; station_alias_r[1]<= 8'h00;
            dl_ctrl_r[0]      <= 8'h00; dl_ctrl_r[1]      <= 8'h00;
            al_ctrl_r[0]      <= 8'h01; al_ctrl_r[1]      <= 8'h00; // INIT state
            eeprom_ctrl_r[0]  <= 8'h00; eeprom_ctrl_r[1]  <= 8'h00;
            eeprom_ctrl_r[2]  <= 8'h00; eeprom_ctrl_r[3]  <= 8'h00;
            eeprom_addr_r[0]  <= 8'h00; eeprom_addr_r[1]  <= 8'h00;
            eeprom_req        <= 0;
            eeprom_cache_valid<= 0;
            sm0_r             <= 64'd0;
            sm1_r             <= 64'd0;
        end else begin
            eeprom_req <= 0;

            if (ec_wr) begin
                casez (ec_addr)
                16'h0010: station_addr_r[0] <= ec_wdata;
                16'h0011: station_addr_r[1] <= ec_wdata;
                16'h0100: dl_ctrl_r[0]      <= ec_wdata;
                16'h0101: dl_ctrl_r[1]      <= ec_wdata;
                16'h0120: al_ctrl_r[0]      <= ec_wdata;
                16'h0121: al_ctrl_r[1]      <= ec_wdata;
                16'h0504: eeprom_addr_r[0]  <= ec_wdata;
                16'h0505: eeprom_addr_r[1]  <= ec_wdata;
                16'h0502: begin
                    // EEPROM read command: bit0=1
                    if (ec_wdata[0]) begin
                        eeprom_word_addr <= {eeprom_addr_r[1], eeprom_addr_r[0]};
                        eeprom_req       <= 1;
                    end
                end
                // SM0 write (0x0800-0x0807) — explicit byte enables
                16'h0800: sm0_r[ 7: 0] <= ec_wdata;
                16'h0801: sm0_r[15: 8] <= ec_wdata;
                16'h0802: sm0_r[23:16] <= ec_wdata;
                16'h0803: sm0_r[31:24] <= ec_wdata;
                16'h0804: sm0_r[39:32] <= ec_wdata;
                16'h0805: sm0_r[47:40] <= ec_wdata;
                16'h0806: sm0_r[55:48] <= ec_wdata;
                16'h0807: sm0_r[63:56] <= ec_wdata;
                // SM1 write (0x0808-0x080F)
                16'h0808: sm1_r[ 7: 0] <= ec_wdata;
                16'h0809: sm1_r[15: 8] <= ec_wdata;
                16'h080A: sm1_r[23:16] <= ec_wdata;
                16'h080B: sm1_r[31:24] <= ec_wdata;
                16'h080C: sm1_r[39:32] <= ec_wdata;
                16'h080D: sm1_r[47:40] <= ec_wdata;
                16'h080E: sm1_r[55:48] <= ec_wdata;
                16'h080F: sm1_r[63:56] <= ec_wdata;
                default:;
                endcase
            end

            // Cache EEPROM read result (only first 16 words = 32 bytes)
            if (eeprom_ack && eeprom_addr_r[0][7:4] == 4'h0) begin
                eeprom_cache[{eeprom_addr_r[0][3:0], 1'b0}] <= eeprom_rdata[7:0];
                eeprom_cache[{eeprom_addr_r[0][3:0], 1'b1}] <= eeprom_rdata[15:8];
                eeprom_cache_valid <= 1;
                // Update status: clear busy bit
                eeprom_ctrl_r[1]  <= 8'h80; // eeprom loaded, no error
            end
        end
    end

    // ── Process data RAM — unified write port (EC and PDI arbitrated) ─────
    // EC writes take priority; PDI writes only when EC is not writing PD RAM.
    // 0x1000-0x107F → addr[15:7] == 9'h020 (128-byte aligned block)
    always @(posedge clk) begin
        if (ec_wr && ec_addr[15:7] == 9'h020)
            pd_ram[ec_addr[6:0]] <= ec_wdata;
        else if (pdi_wr && pdi_addr[15:7] == 9'h020)
            pd_ram[pdi_addr[6:0]] <= pdi_wdata;
    end

    // ── PDI (SPI slave) port — process data RAM read ──────────────────────
    always @(*) begin
        pdi_rdata = 8'hFF;
        if (pdi_rd && pdi_addr[15:7] == 9'h020)
            pdi_rdata = pd_ram[pdi_addr[6:0]];
    end

    // Drive AL status output
    always @(posedge clk or negedge rst_n) begin
        if (!rst_n)
            al_status <= 4'h1; // INIT
        else
            al_status <= al_state_in;
    end

endmodule
