VasuPadsumbia/micro-ros-ethercat/(commit log)

2026-04-08 feat: Implement micro-ROS EtherCAT firmware for ESP32 with custom SPI transport
    - Add CMakeLists.txt for main firmware component.
    - Create main.c to handle micro-ROS node operations, including publishing and subscribing to topics.
    - Implement spi_transport.c for SPI communication with Tang Nano 20K FPGA, including CRC and command handling.
    - Define spi_transport.h for transport interface and constants.
    - Add sdkconfig.defaults for ESP-IDF configuration tailored for micro-ROS.
    - Create test framework in test directory with CMakeLists.txt and test_spi_transport.c for unit testing SPI transport logic.
    - Add requirements.txt for Python dependencies related to testing and simulation.
    - Develop sc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
2026-04-11 refactor: update SPI transport implementation and project build configuration
2026-06-01 Refactor EtherCAT slave top module and add configuration generation script
    - Updated top.v to support single-port EtherCAT slave configuration.
    - Introduced a new script function to generate slave_config.vh from config.in, allowing for dynamic configuration of various parameters such as PHY address, station address, mailbox base addresses, and I2C clock division.
    - Improved comments and organization within top.v for better clarity and maintainability.
